jpmora403/Electronic-Speed-Controller/kicad_sch/esc_schematicv1.kicad_sch

## KiCad design kicad_sch/esc_schematicv1.kicad_sch (2026-03-20)

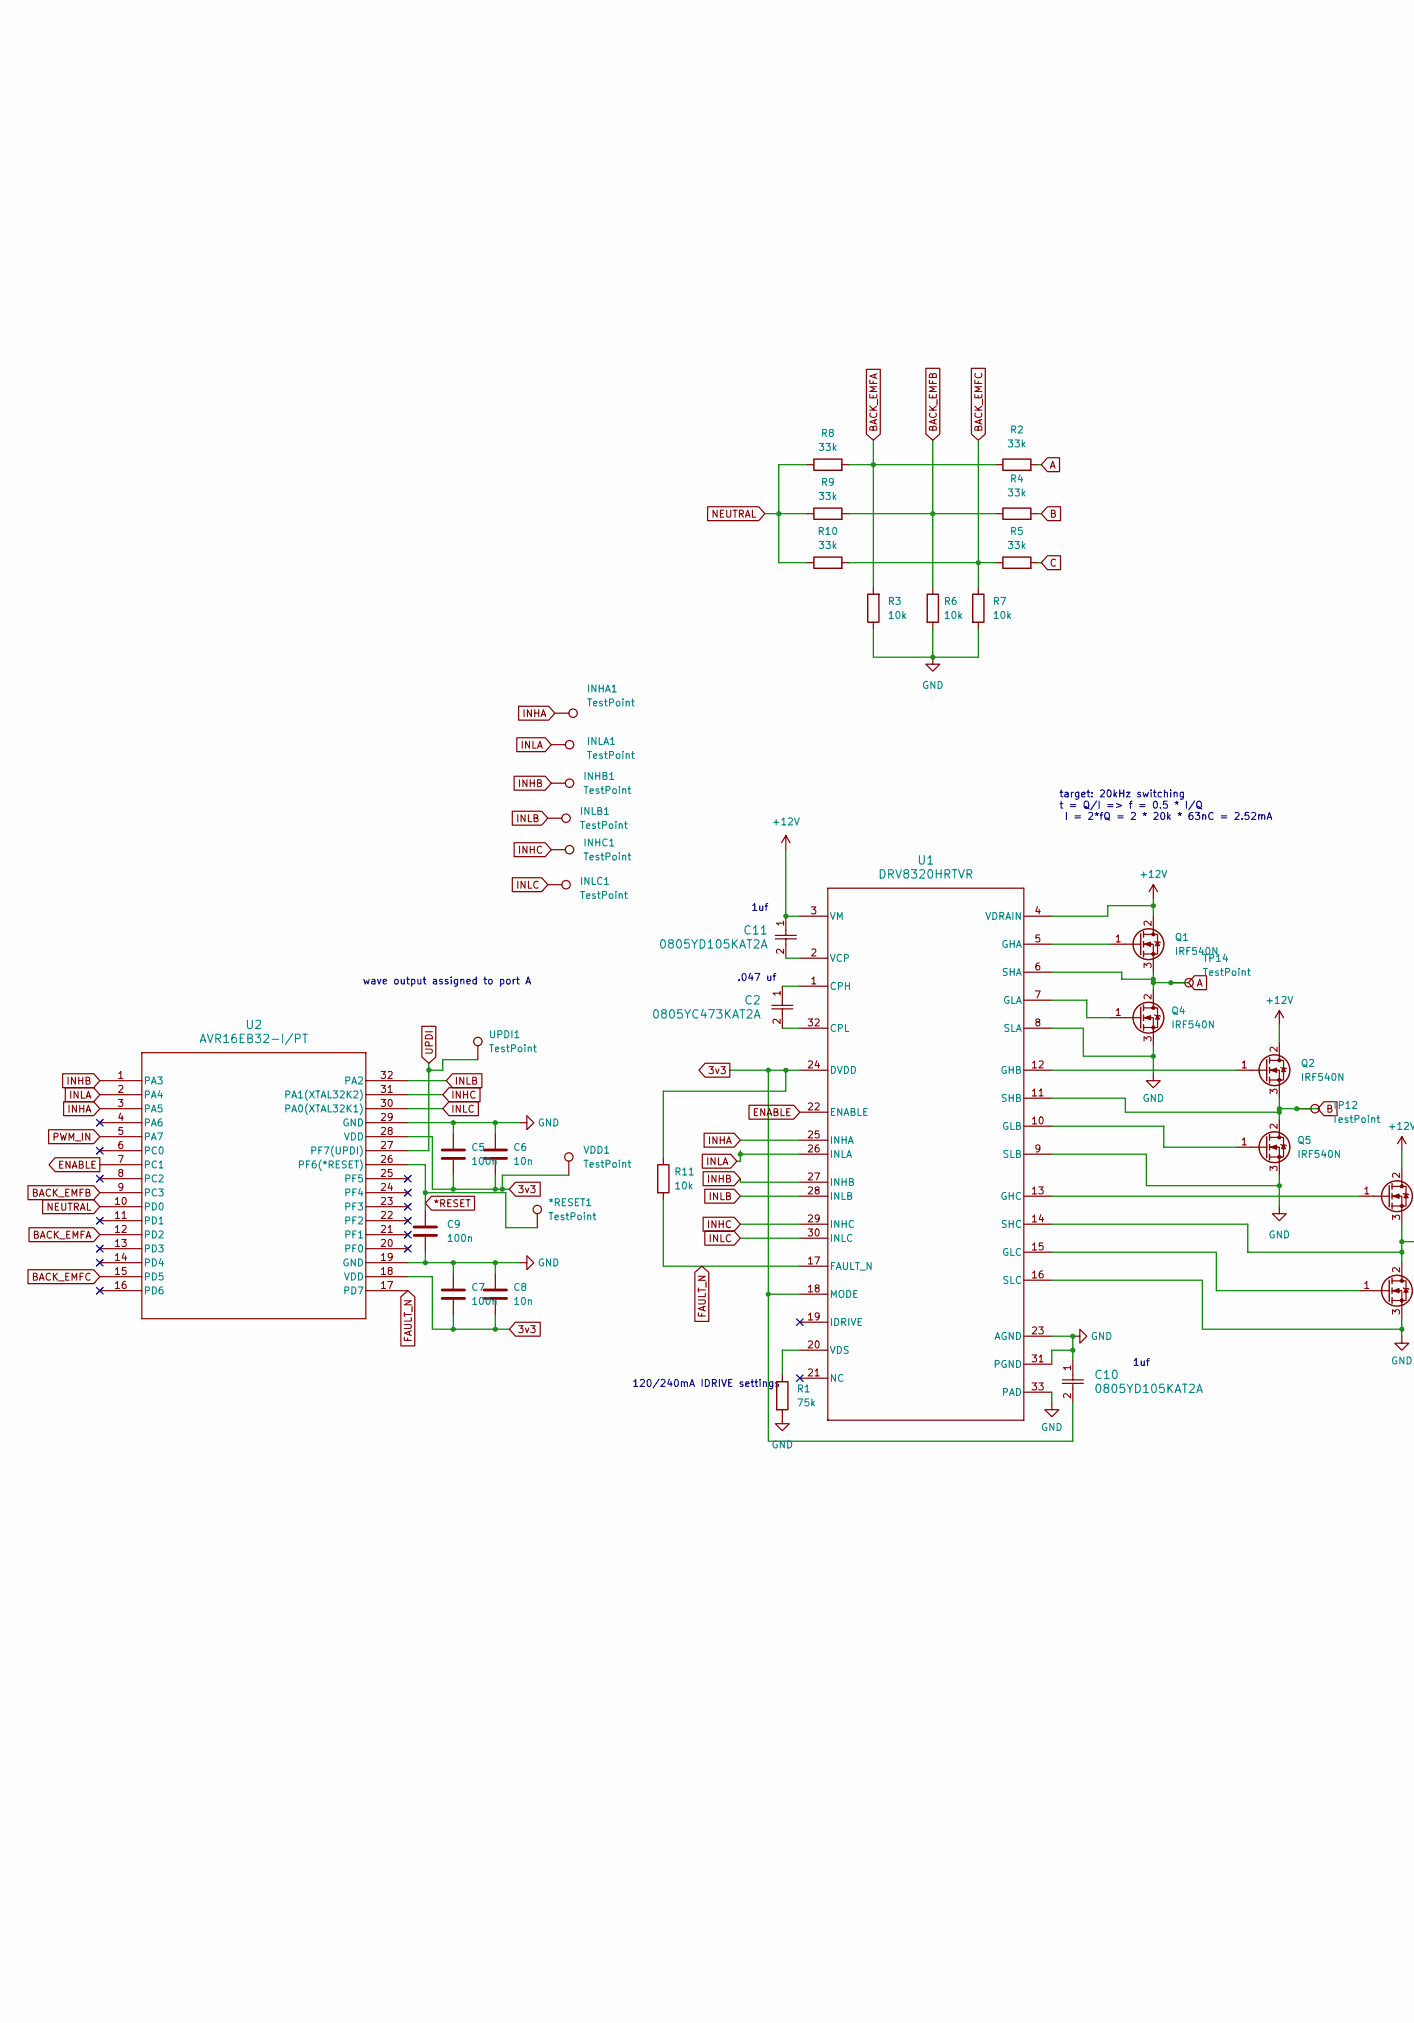
[picture p1: schematic esc_schematicv1.kicad_sch, part in row 1, column 1]

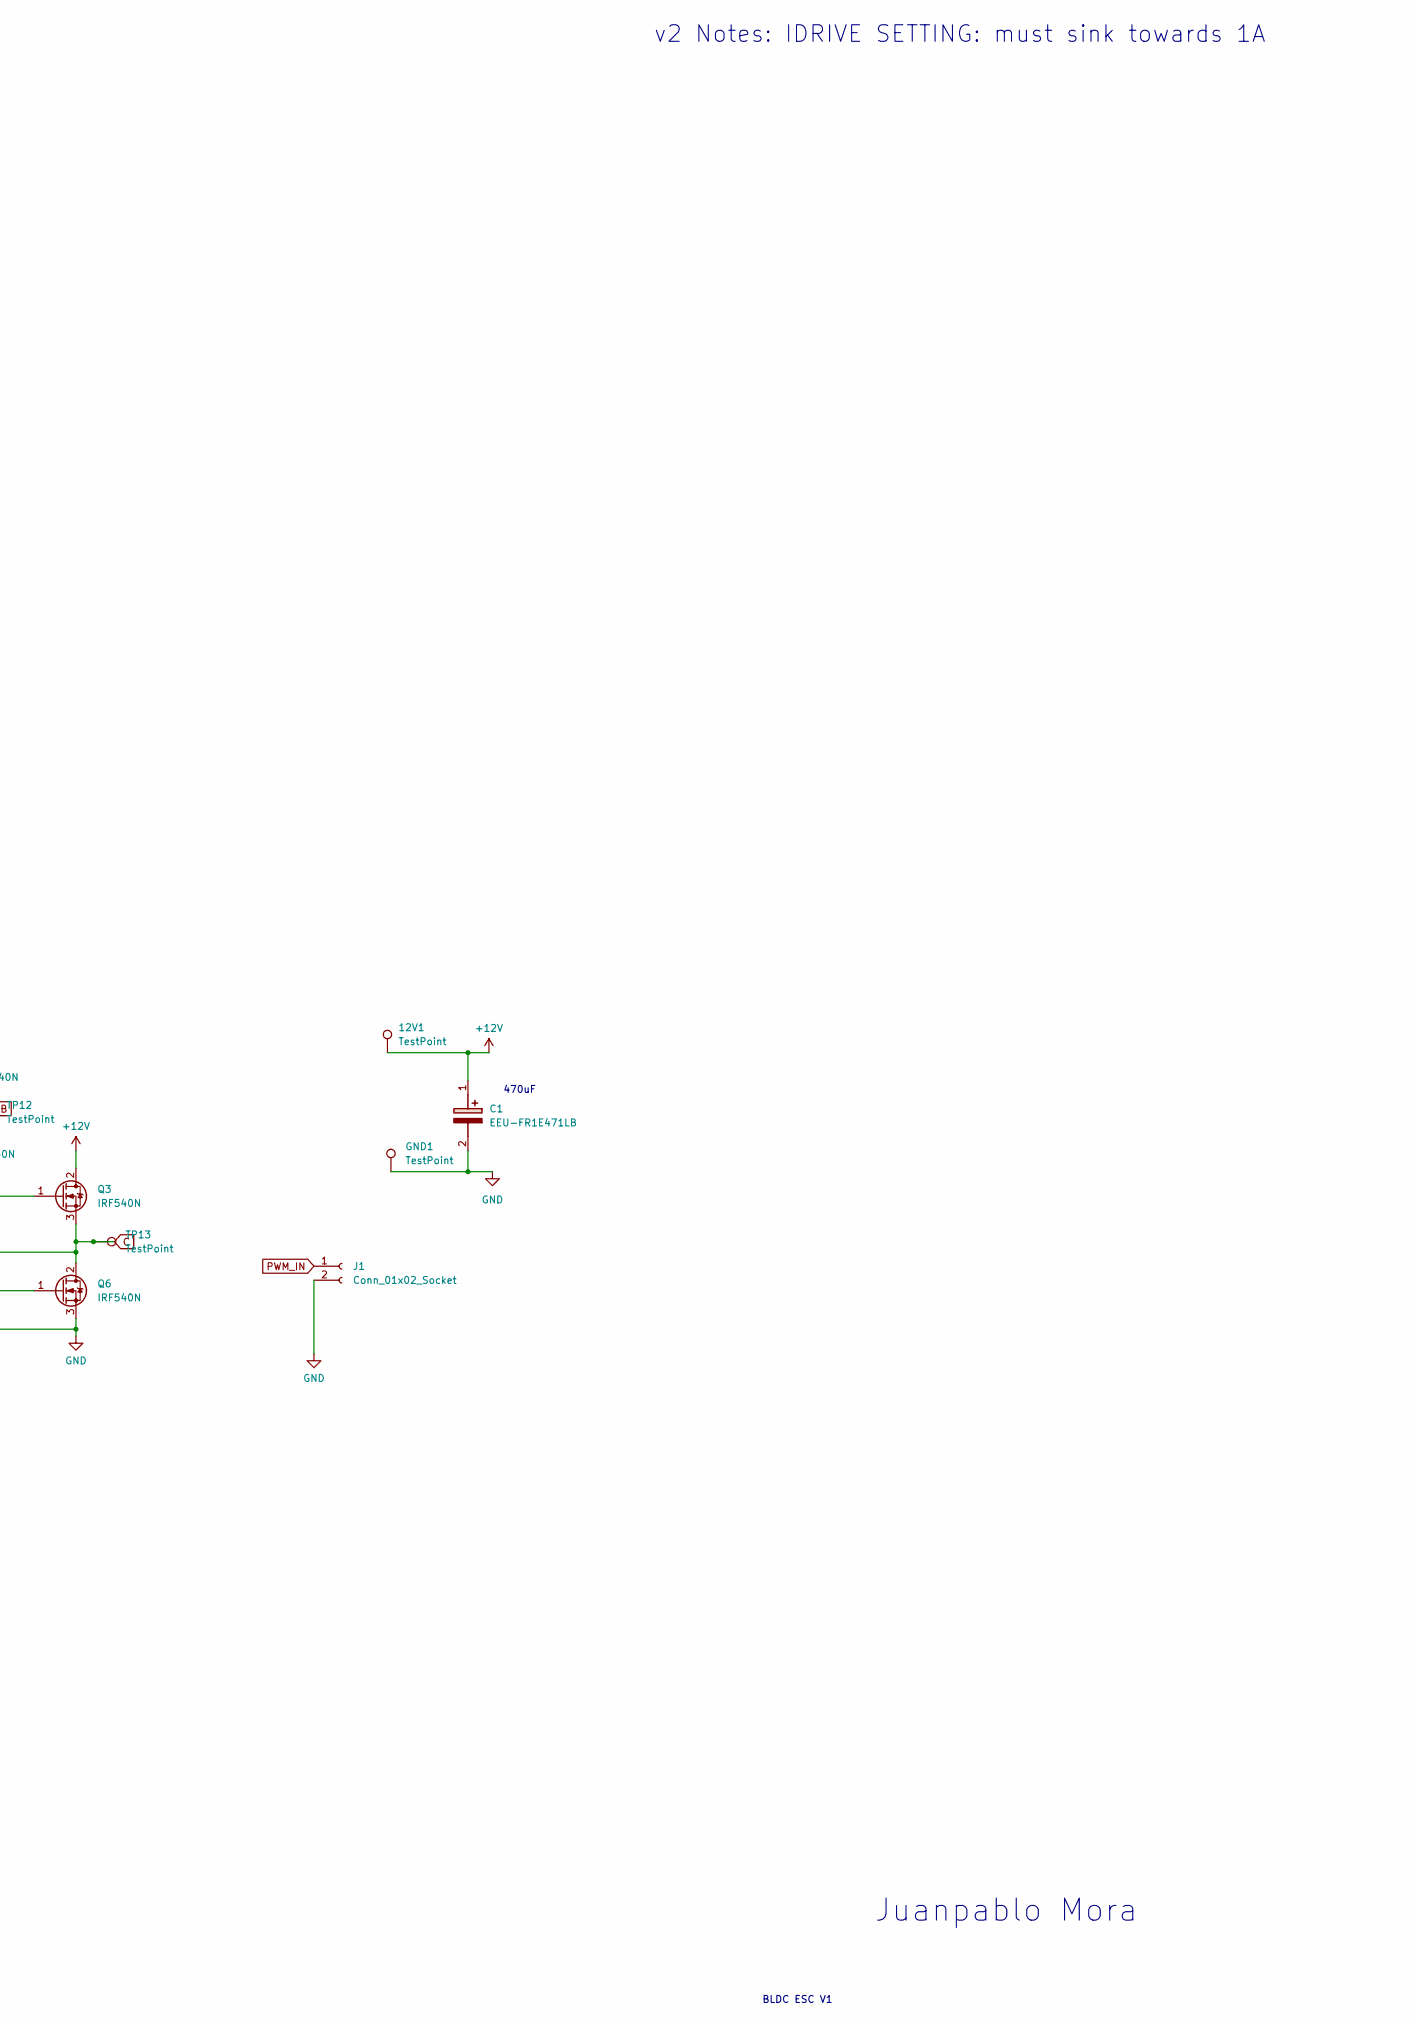
[picture p2: schematic esc_schematicv1.kicad_sch, part in row 1, column 2]

Parts:
12V1: TestPoint; TestPoint_Pad_4.0x4.0mm
*RESET1: TestPoint; TestPoint_Plated_Hole_D2.0mm
C1: EEU-FR1E471LB; CAPPRD350W65D800H2200; Mouser Part Number 667-EEU-FR1E471LB
C2: 0805YC473KAT2A; 0805_AVX
C5, C7, C9: 100n; CAP_0805N_AVX
C6, C8: 10n; CAP_0805N_AVX
C10, C11: 0805YD105KAT2A; CAP_0805N_AVX
GND1: TestPoint; TestPoint_Pad_4.0x4.0mm
INHA1: TestPoint; TestPoint_Plated_Hole_D2.0mm
INHB1: TestPoint; TestPoint_Plated_Hole_D2.0mm
INHC1: TestPoint; TestPoint_Plated_Hole_D2.0mm
INLA1: TestPoint; TestPoint_Plated_Hole_D2.0mm
INLB1: TestPoint; TestPoint_Plated_Hole_D2.0mm
INLC1: TestPoint; TestPoint_Plated_Hole_D2.0mm
J1: Conn_01x02_Socket; SolderWire-0.1sqmm_1x02_P3.6mm_D0.4mm_OD1mm
Q1, Q2, Q3, Q4, Q5, Q6: IRF540N; TO-220-3_Horizontal_TabDown
R1: 75k; R_0805_2012Metric
R2, R4, R5, R8, R9, R10: 33k; R_0805_2012Metric
R3, R6, R7, R11: 10k; R_0805_2012Metric
TP12, TP13, TP14: TestPoint; TestPoint_Pad_4.0x4.0mm
U1: DRV8320HRTVR; RTV0032E
U2: AVR16EB32-I/PT; TQFP32_PT_MCH
UPDI1: TestPoint; TestPoint_Plated_Hole_D2.0mm
VDD1: TestPoint; TestPoint_Plated_Hole_D2.0mm

Connections:
3v3: C5.2, C6.2, C7.2, C8.2, C10.2, R11.1, U1.18 (MODE), U1.24 (DVDD), U2.18 (VDD), U2.28 (VDD), VDD1.1
+12V: 12V1.1, C1.1 (+), C11.1, Q1.2 (D), Q2.2 (D), Q3.2 (D), U1.3 (VM), U1.4 (VDRAIN)
A: Q1.3 (S), Q4.2 (D), R2.2, TP14.1, U1.6 (SHA)
B: Q2.3 (S), Q5.2 (D), R4.2, TP12.1, U1.11 (SHB)
BACK_EMFA: R2.1, R3.2, R8.2, U2.12 (PD2)
BACK_EMFB: R4.1, R6.1, R9.2, U2.9 (PC3)
BACK_EMFC: R5.1, R7.1, R10.2, U2.15 (PD5)
C: Q3.3 (S), Q6.2 (D), R5.2, TP13.1, U1.14 (SHC)
ENABLE: U1.22 (ENABLE), U2.7 (PC1)
FAULT_N: R11.2, U1.17 (FAULT_N), U2.17 (PD7)
GND: C1.2 (-), C5.1, C6.1, C7.1, C8.1, C9.2, C10.1, GND1.1, J1.2, Q4.3 (S), Q5.3 (S), Q6.3 (S), R1.2, R3.1, R6.2, R7.2, U1.8 (SLA), U1.9 (SLB), U1.16 (SLC), U1.23 (AGND), U1.31 (PGND), U1.33 (PAD), U2.19 (GND), U2.29 (GND)
INHA: INHA1.1, U1.25 (INHA), U2.3 (PA5)
INHB: INHB1.1, U1.27 (INHB), U2.1 (PA3)
INHC: INHC1.1, U1.29 (INHC), U2.31 (PA1(XTAL32K2))
INLA: INLA1.1, U1.26 (INLA), U2.2 (PA4)
INLB: INLB1.1, U1.28 (INLB), U2.32 (PA2)
INLC: INLC1.1, U1.30 (INLC), U2.30 (PA0(XTAL32K1))
NEUTRAL: R8.1, R9.1, R10.1, U2.10 (PD0)
unnamed: C2.1, U1.1 (CPH)
unnamed: C2.2, U1.32 (CPL)
unnamed: C11.2, U1.2 (VCP)
unnamed: Q1.1 (G), U1.5 (GHA)
unnamed: Q2.1 (G), U1.12 (GHB)
unnamed: Q3.1 (G), U1.13 (GHC)
unnamed: Q4.1 (G), U1.7 (GLA)
unnamed: Q5.1 (G), U1.10 (GLB)
unnamed: Q6.1 (G), U1.15 (GLC)
unnamed: R1.1, U1.20 (VDS)
PWM_IN: J1.1, U2.5 (PA7)
UPDI: U2.27 (PF7(UPDI)), UPDI1.1
reset: *RESET1.1, C9.1, U2.26 (PF6(*RESET))

Notes on the sheet:
.047 uf
1uf
wave output assigned to port A
Juanpablo Mora
v2 Notes: IDRIVE SETTING: must sink towards 1A
target: 20kHz switching t = Q/I => f = 0.5 * I/Q I = 2*fQ = 2 * 20k * 63nC = 2.52mA
120/240mA IDRIVE settings
470uF
BLDC ESC V1
