jpmora403/Electronic-Speed-Controller/(commit log)

2026-03-20 added schematic and gerber files
    [esc_schematic-B_Mask.gbr, esc_schematic-B_Paste.gbr, esc_schematic-B_Silkscreen.gbr, esc_schematic-Back.gbr, esc_schematic-Edge_Cuts.gbr, esc_schematic-F_Mask.gbr, esc_schematic-F_Paste.gbr, esc_schematic-F_Silkscreen.gbr]
2026-03-26 added kicad project file
2026-03-27 Deadtime issue fixed, inverted signals tested and confirmed
    [esc.c, tce.c, wex.c]
2026-03-31 creating usart driver for output char for debugging
2026-04-24 confirm tcb interrupt firing
2026-04-24 Add and compile printf submodule
2026-04-24 confirm printf
2026-04-27 pwm input changed to pc0, confirmed working
2026-04-27 pwm input added back to pa7/j1, confirmed working
2026-04-27 Add throttle value calculation
2026-04-27 Fix: next state logic ToDo: tweak AC initialization
    [ac.c, esc.c, state_machine.c]
2026-05-01 toDo: stall logic
2026-05-19 Correct floating phase logic
    [esc.c, state_machine.c]
